jelsdon/low-power-monitor/(commit log)

2023-01-08 Add schematics/connectivity
2023-01-09 Switch to BME280 I2C address 0x76
